shinrinakamura/openhard-coffeemaker/README.md

# openhard-coffeemaker
オープンハード大作戦の一環としてコーヒー残量計の設計情報などを公開します。

レーザーカッターでの加工用データはイラストレーター等を利用して、レーザーカッターに合わせたデータ形式に適宜変換して使用してください。<br>
3次元データについてはfusion360等の3次元CADで開いてください。
