shinrinakamura/openhard-coffeemaker/ロードセルによる重量測定装置の作り方.pdf

# ロードセルによる重量測定装置の作り方

# 株式会社

B

# ＆B Lab. ハイパーメディアクリエーター

### 中村真理 s_nakamura@b-and-b-lab.jp

2022.04.06

# 完成図

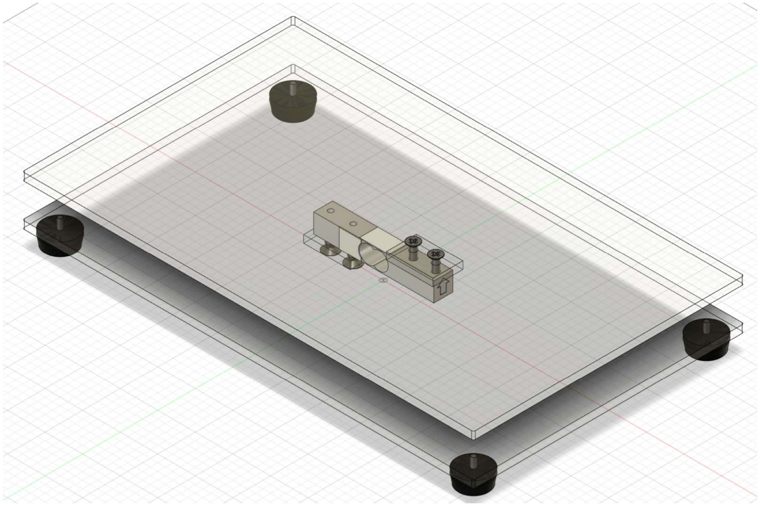
[picture p1: page 3]

# 必要部材

# ■アクリル板

# 〇透明アクリル板（5×180×320mm） ×２

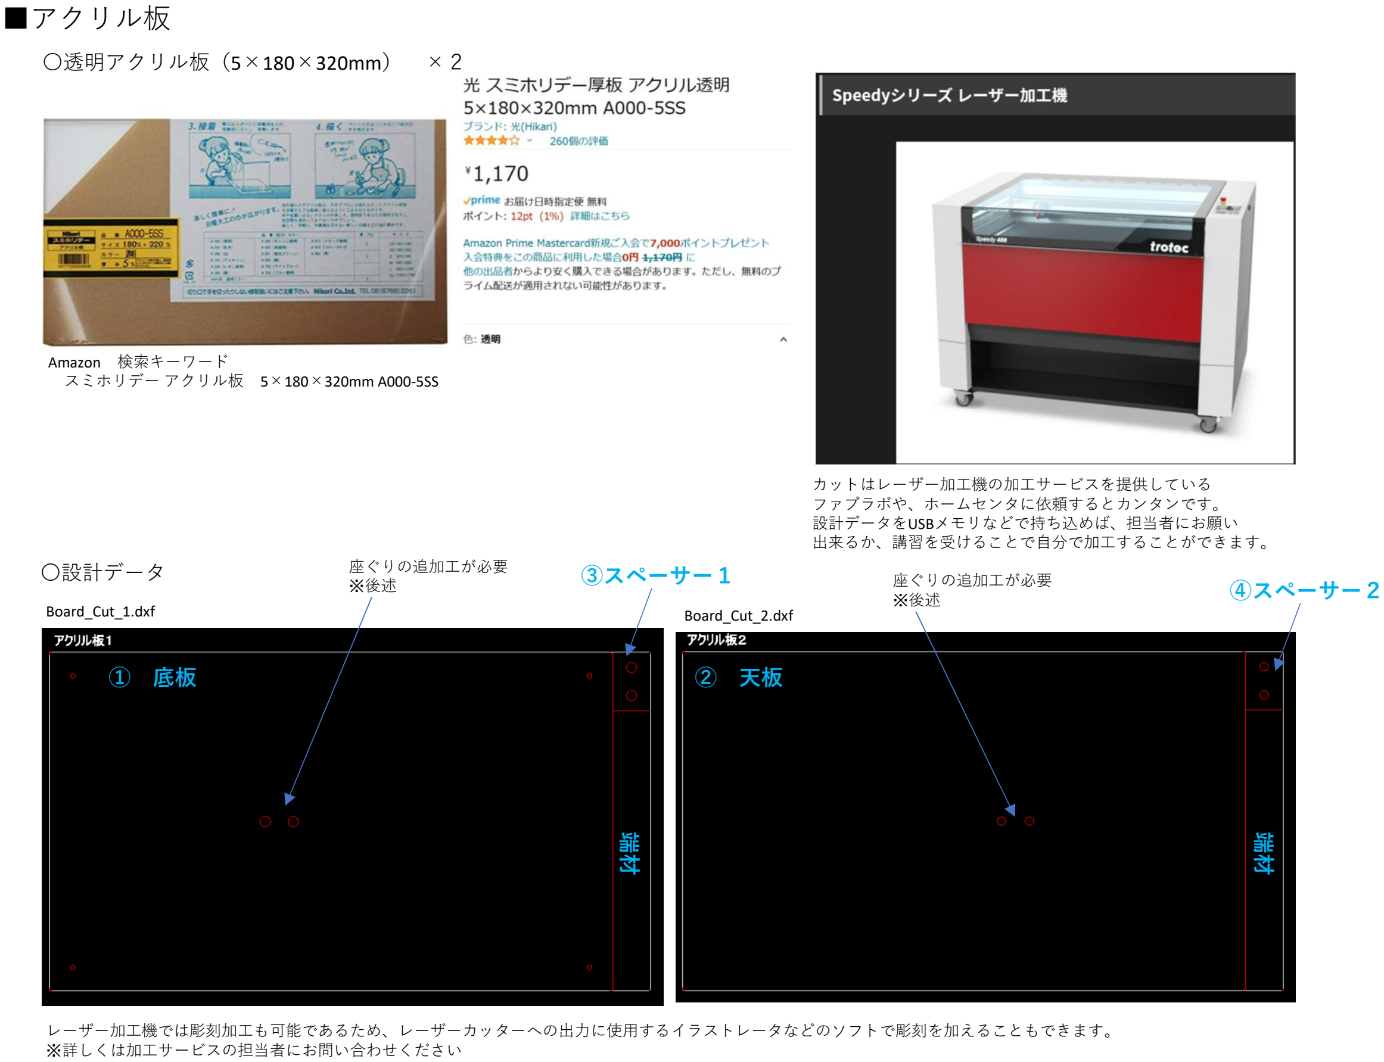
[picture p2: page 5]

# Amazon 検索キーワード

スミホリデー アクリル板 5×180×320mm A000-5SS

Board_Cut_1.dxf | Board_Cut_2.dxf

# 〇設計データ

# カットはレーザー加工機の加工サービスを提供している ファブラボや、ホームセンタに依頼するとカンタンです。 設計データをUSBメモリなどで持ち込めば、担当者にお願い 出来るか、講習を受けることで自分で加工することができます。

① 底板 | ② 天板

端材

端材

# ④スペーサー２ ③スペーサー１

# レーザー加工機では彫刻加工も可能であるため、レーザーカッターへの出力に使用するイラストレータなどのソフトで彫刻を加えることもできます。 ※詳しくは加工サービスの担当者にお問い合わせください

# 座ぐりの追加工が必要

※後述 | 座ぐりの追加工が必要
| ※後述

# ■ロードセル 参考URL

# フルスケール ２ｋｇ ×１

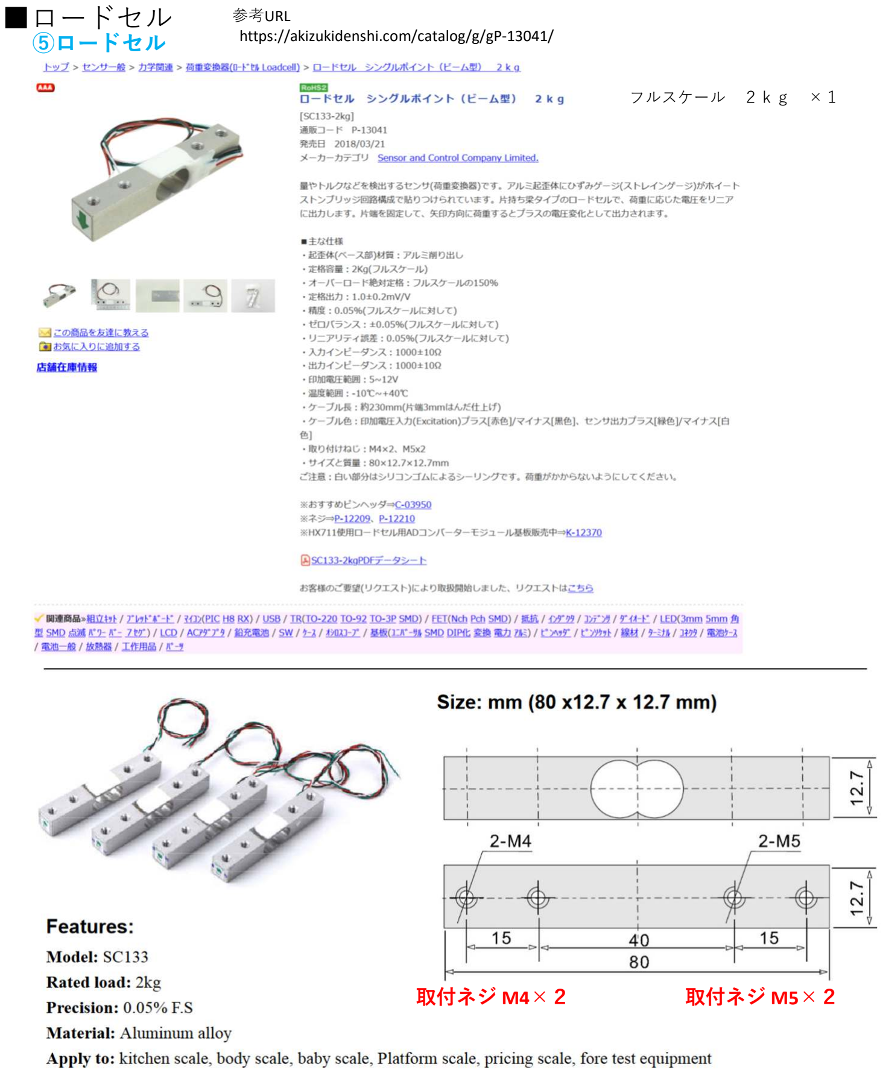
[picture p3: page 6]

取付ネジ M4×２ | 取付ネジ M5×２

https://akizukidenshi.com/catalog/g/gP-13041/

# ⑤ロードセル

# ■ネジ類

# 〇M4×20mm 皿ねじ : ２本

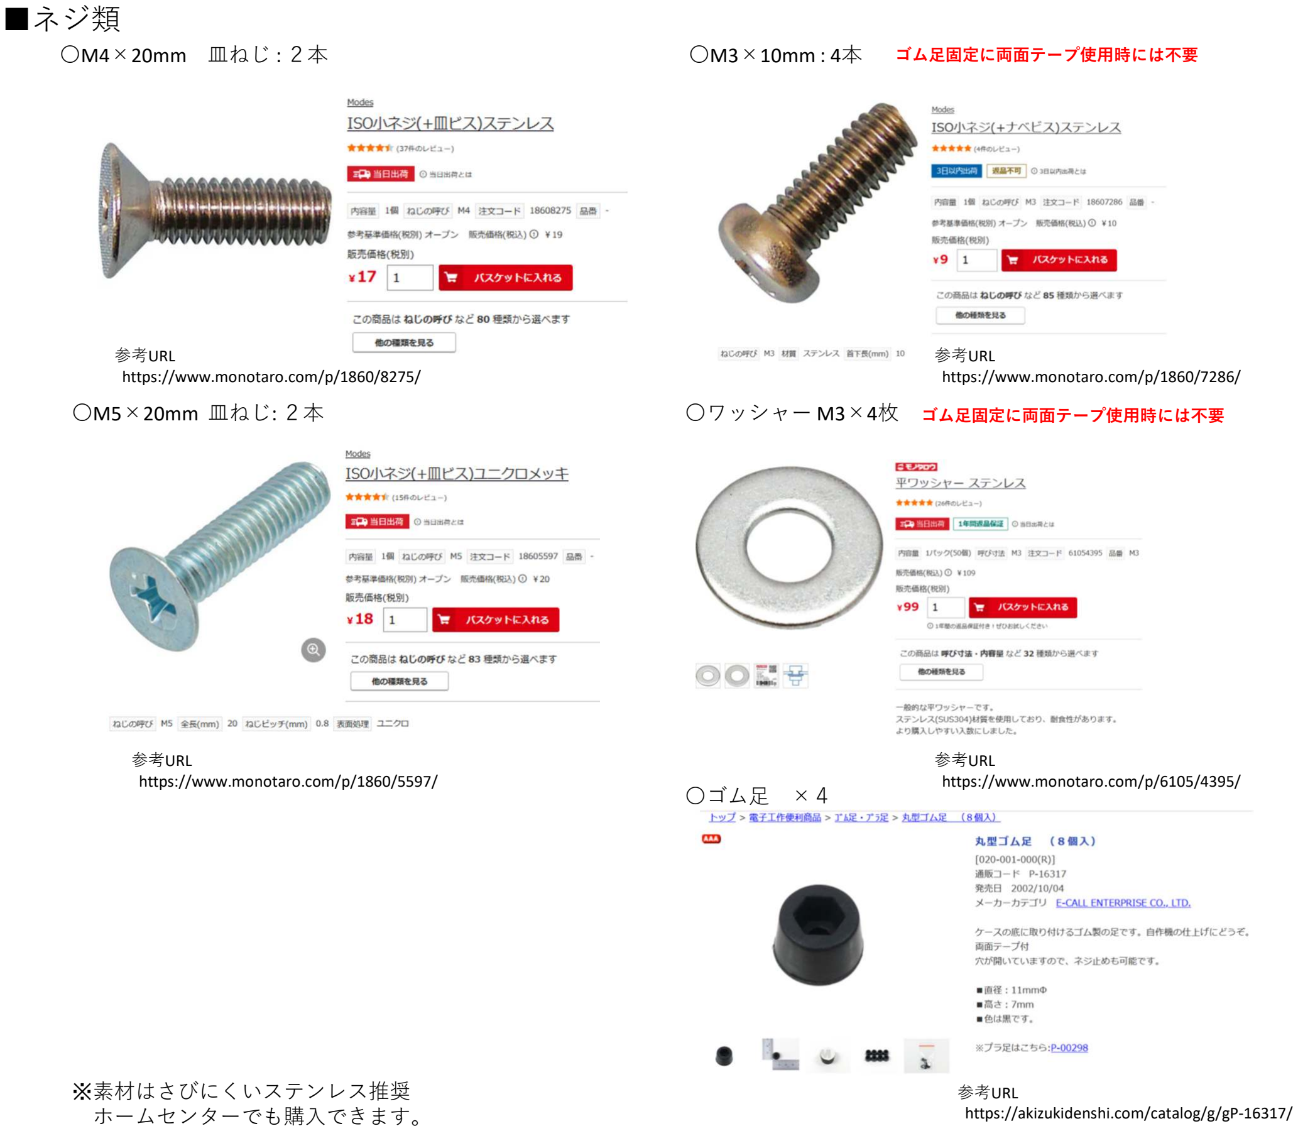
[picture p4: page 7]

参考URL

https://www.monotaro.com/p/1860/8275/

参考URL

https://www.monotaro.com/p/1860/5597/

# 〇M5×20mm 皿ねじ: ２本

### 〇M3×10mm : 4本

参考URL

https://www.monotaro.com/p/1860/7286/

# 〇ワッシャー M3×4枚

参考URL

https://www.monotaro.com/p/6105/4395/ 〇ゴム足 ×４

参考URL

https://akizukidenshi.com/catalog/g/gP-16317/

# ※素材はさびにくいステンレス推奨 ホームセンターでも購入できます。

# ゴム足固定に両面テープ使用時には不要

# ゴム足固定に両面テープ使用時には不要

# HX711搭載基板 ×１

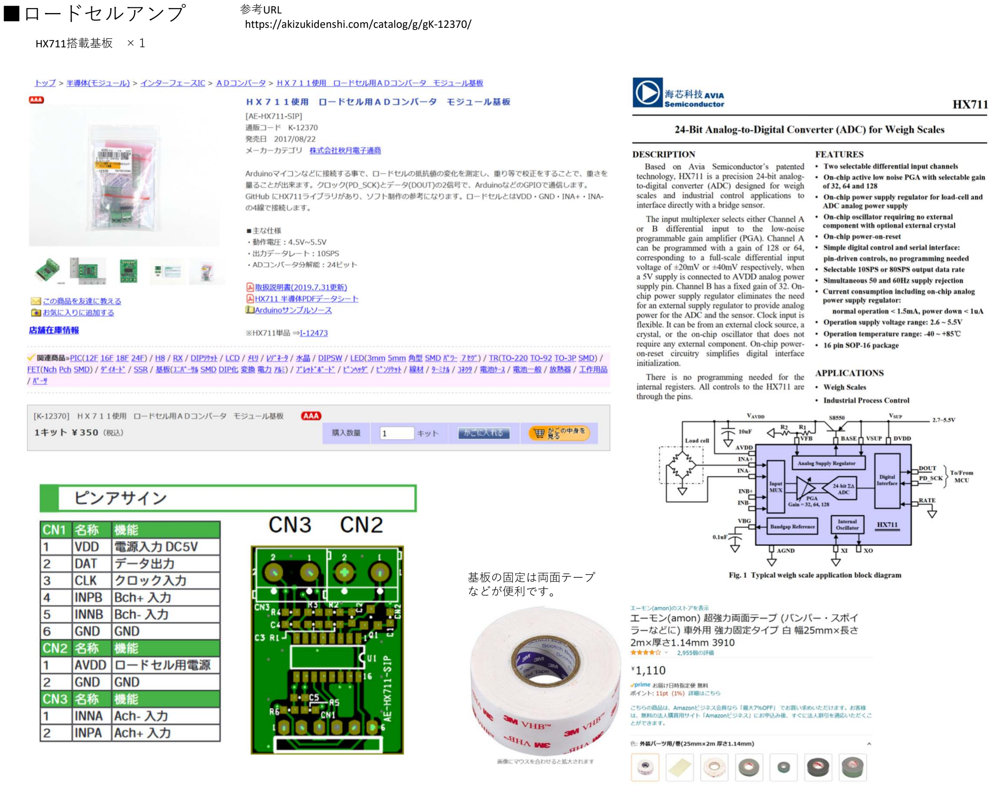
[picture p5: page 8]

■ロードセルアンプ | 参考URL https://akizukidenshi.com/catalog/g/gK-12370/

# 基板の固定は両面テープ などが便利です。

# ■特殊工具

# 〇タップ M3用

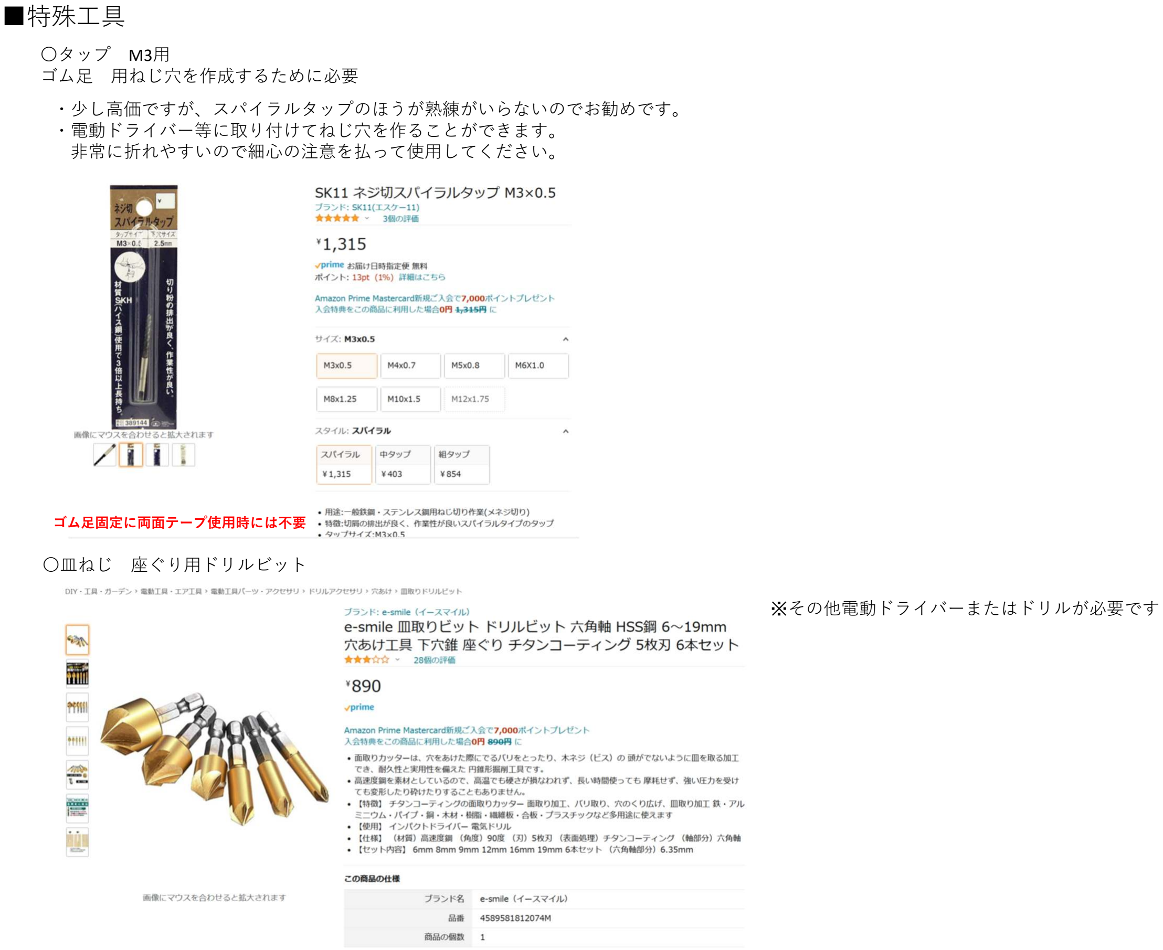
[picture p6: page 9]

# ゴム足 用ねじ穴を作成するために必要 ・少し高価ですが、スパイラルタップのほうが熟練がいらないのでお勧めです。 ・電動ドライバー等に取り付けてねじ穴を作ることができます。 非常に折れやすいので細心の注意を払って使用してください。

# ゴム足固定に両面テープ使用時には不要

# 〇皿ねじ 座ぐり用ドリルビット ※その他電動ドライバーまたはドリルが必要です

# 組み立て図

# ② 天板

# ④スペーサー２

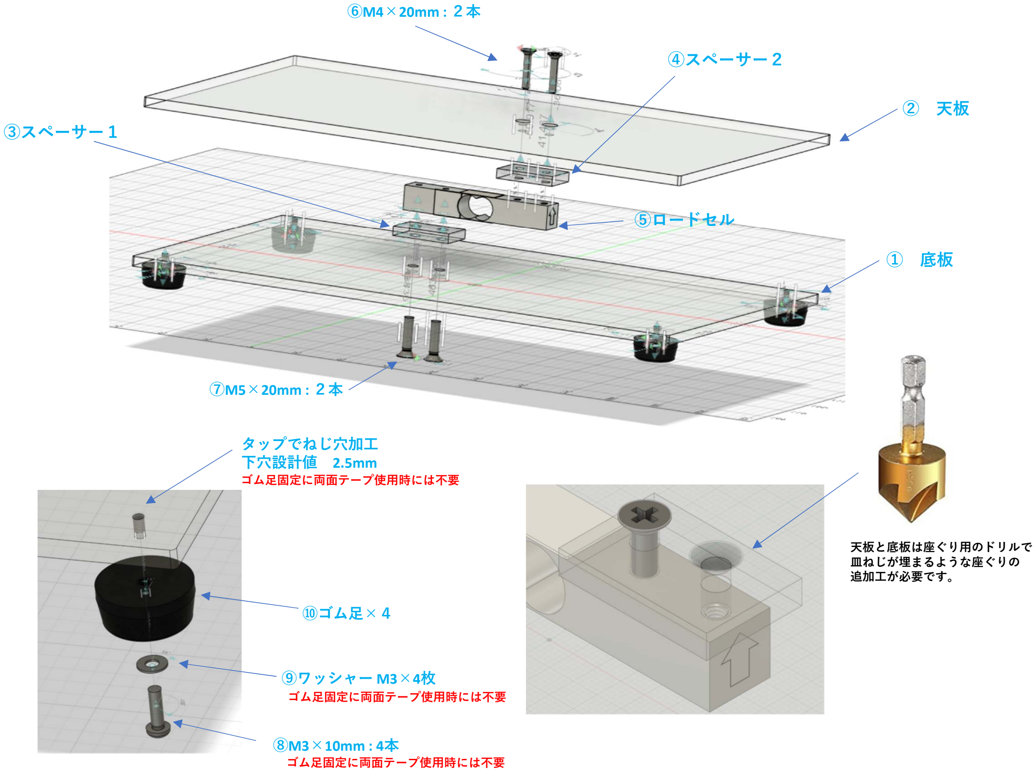
[picture p7: page 11]

# ① 底板

# ③スペーサー１

# ⑤ロードセル

⑥M4×20mm : ２本

⑦M5×20mm : ２本

# タップでねじ穴加工 下穴設計値 2.5mm

⑧M3×10mm : 4本

# ⑨ワッシャー M3×4枚

# ゴム足固定に両面テープ使用時には不要

# ゴム足固定に両面テープ使用時には不要

# ゴム足固定に両面テープ使用時には不要

# ⑩ゴム足×４

# 天板と底板は座ぐり用のドリルで 皿ねじが埋まるような座ぐりの 追加工が必要です。

# 配線図、プログラム

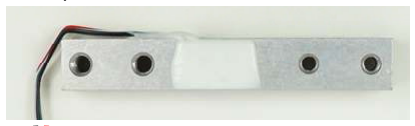
[picture p8: figure]
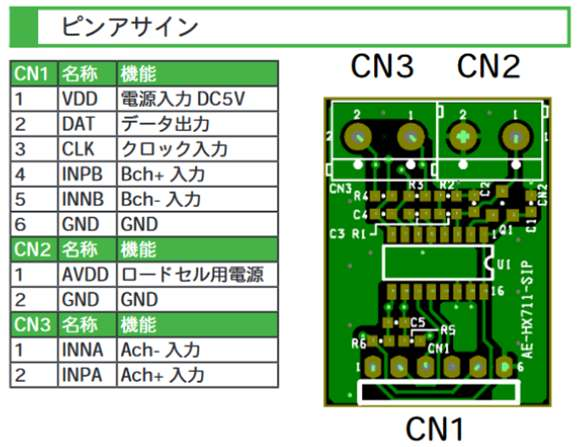
[picture p9: figure]

https://akizukidenshi.com/catalog/g/gK-12370/

# ロードセル

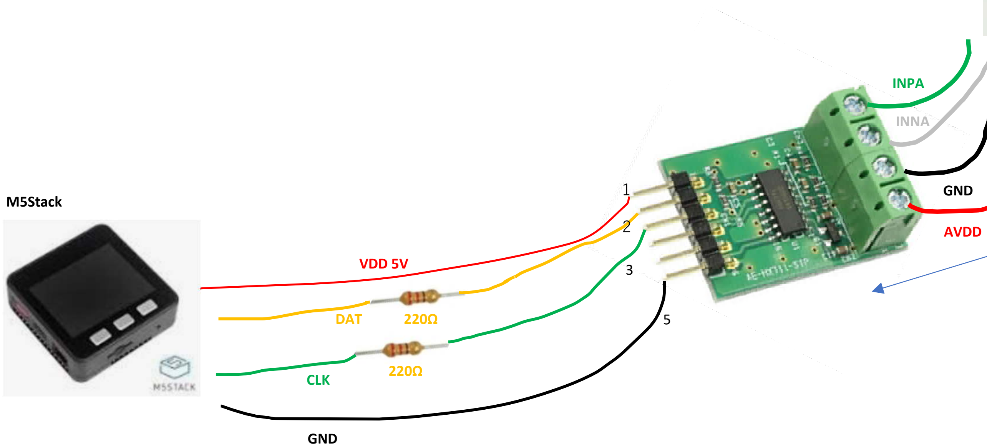
[picture p10: figure]
AVDD; GND; INNA; INPA; VDD 5V; DAT; CLK; M5Stack

# 両面テープで底板に固定

# 配線図

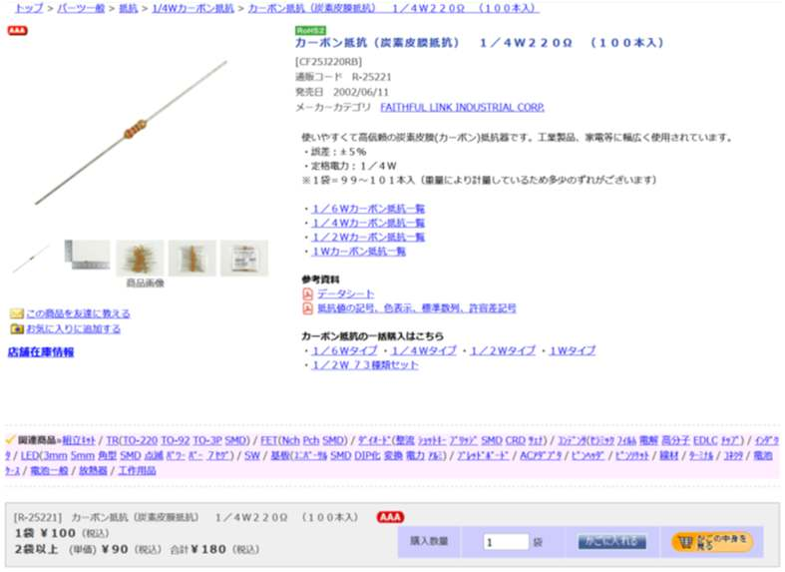
[picture p11: figure]

https://akizukidenshi.com/catalog/g/gR-25221/

■抵抗 1/4W 220 Ω

# 電源電圧が5Vであるため、IO電圧も５Vとなる。

一方、M5StackやESP32等はIO電圧が 3.3V のため

# 簡易レベル変換としてDAT,CLKラインに直列に抵抗（220Ω） を挿入する必要がある。

# プログラムについて

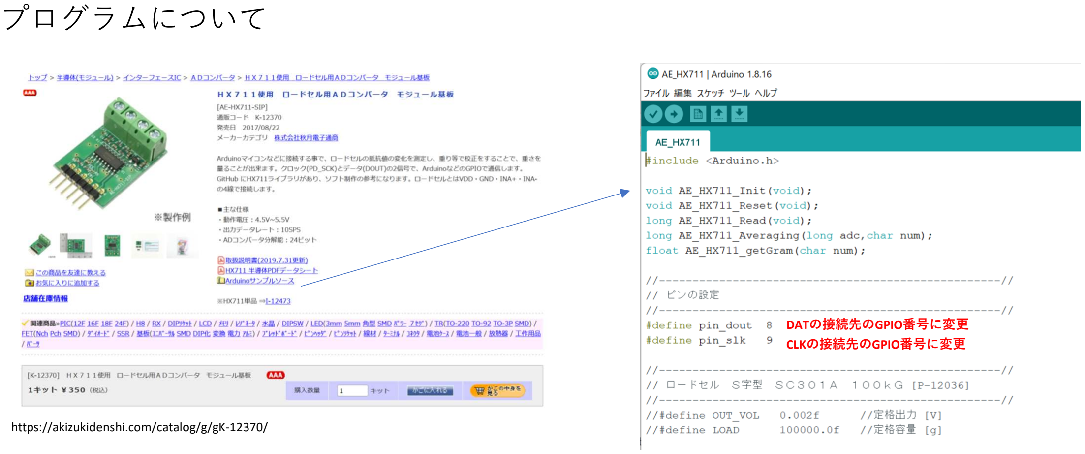
[picture p12: page 14]

https://akizukidenshi.com/catalog/g/gK-12370/

# DATの接続先のGPIO番号に変更 CLKの接続先のGPIO番号に変更

# Presented By

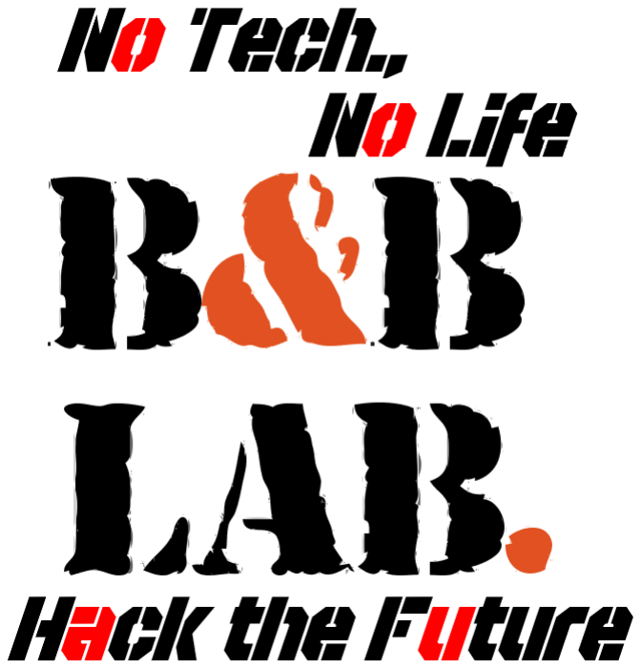
[picture p13: figure]
