shinrinakamura/openhard-coffeemaker/Coffee_Scale v5.step

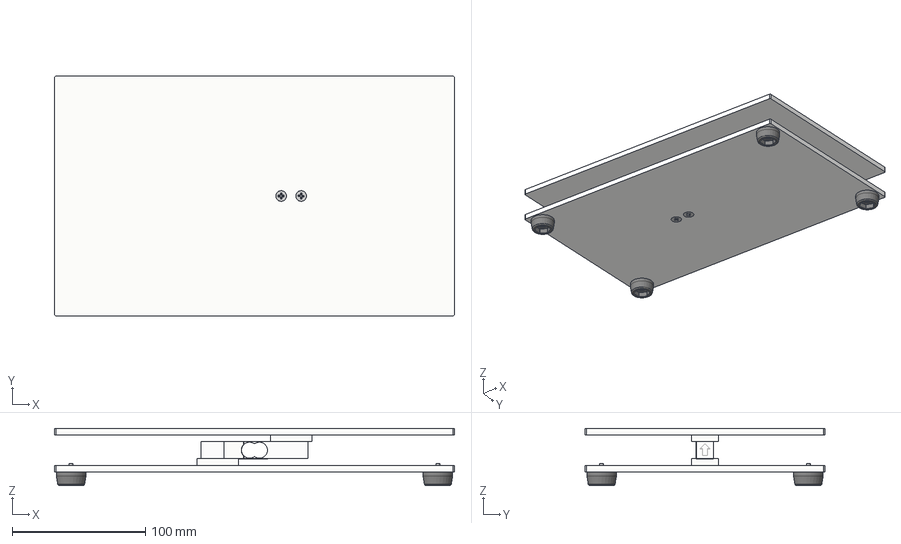
[picture p14: CAD file, 2022-04-06]
Coffee_Scale v5.step
300.0 x 180.0 x 42.9 mm
W0-00-0000-0030-0000_SCiXfX_4 x 4
bottom_board
foot_rubber x 4
BKJ3-10_amaeTa_4 x 4
Load_Cell_2kg
spacer_2
spacer_1
BFBJ5-20_AbgcMW_2 x 2
top_board
CSPCSZ-ST-M4-20_yCHKBj_2 x 2
