shinrinakamura/openhard-coffeemaker/Board_Cut_2.dxf

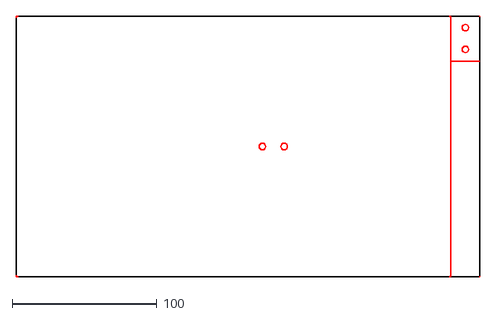
[picture p15: CAD file, 2022-04-06]
Board_Cut_2.dxf
320.0 x 180.0
