shinrinakamura/openhard-coffeemaker/Board_Cut_1.dxf

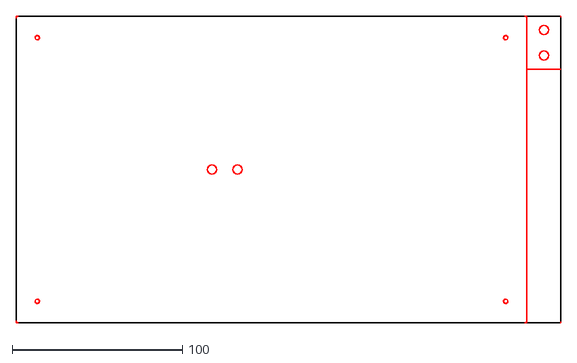
[picture p16: CAD file, 2022-04-06]
Board_Cut_1.dxf
320.0 x 180.0
