shinrinakamura/openhard-coffeemaker/(commit log)

2022-04-06 レーザーカッターのデータ
    [Board_Cut_1.dxf]
2022-04-06 レーザーカッター２
    [Board_Cut_2.dxf]
2022-04-06 3次元データです
    [Coffee_Scale v5.step]
2022-04-06 設計情報です。
